coredump/VzBoT-UserMods/coredump/TripleZ10mm/CAD/Triple Z Kinematic - 10mm Ball - Rear.step

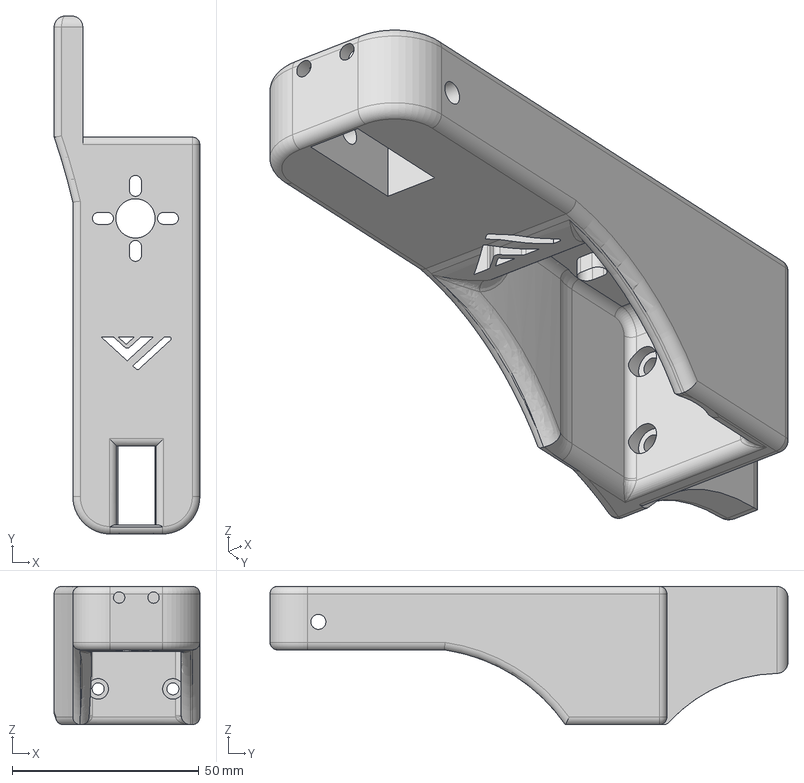
[picture p6: CAD file, 2023-02-21]
coredump/TripleZ10mm/CAD/Triple Z Kinematic - 10mm Ball - Rear.step
39.0 x 138.6 x 37.0 mm
