coredump/VzBoT-UserMods/coredump/TripleZ10mm/CAD/Triple Z Kinematic - 10mm Ball - Right.step

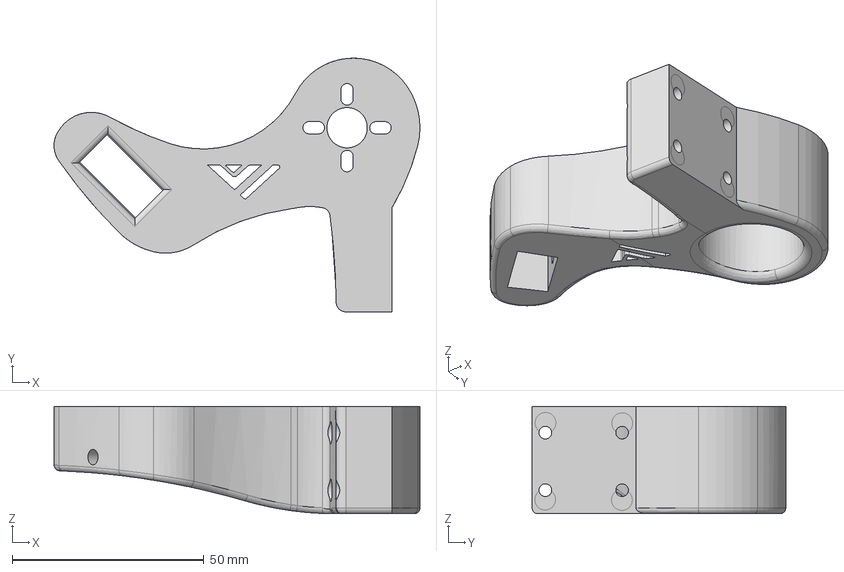
[picture p7: CAD file, 2023-02-21]
coredump/TripleZ10mm/CAD/Triple Z Kinematic - 10mm Ball - Right.step
95.4 x 66.1 x 28.0 mm
