coredump/VzBoT-UserMods/coredump/TripleZ10mm/CAD/Triple Z Kinematic - 10mm Ball - Magnet Block.step

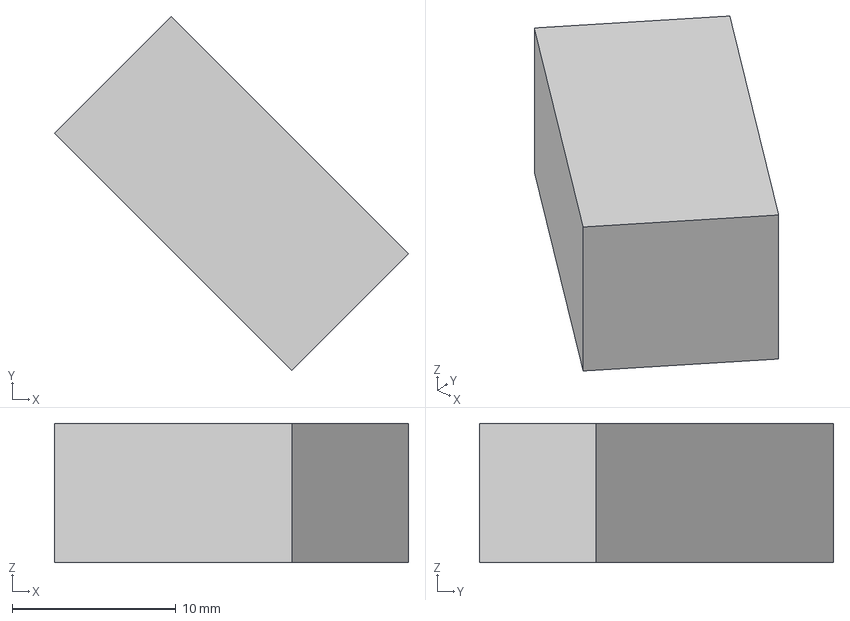
[picture p8: CAD file, 2023-02-21]
coredump/TripleZ10mm/CAD/Triple Z Kinematic - 10mm Ball - Magnet Block.step
21.6 x 21.6 x 8.50 mm
