coredump/VzBoT-UserMods/(list of files, cad)

Other CAD files:
coredump/TripleZ10mm/CAD/Triple Z Kinematic - 10mm Ball - Left.step
coredump/TripleZ10mm/STL/Triple Z Kinematic - 10mm Ball - Left.3mf
coredump/TripleZ10mm/STL/Triple Z Kinematic - 10mm Ball - Magnet Block.3mf
coredump/TripleZ10mm/STL/Triple Z Kinematic - 10mm Ball - Rear.3mf
coredump/TripleZ10mm/STL/Triple Z Kinematic - 10mm Ball - Right.3mf
